Rayan-Radwan/smart-home-control-hub-pic16f877a/docs/Smart Home Block diagram.drawio.pdf

# Smart Home Block Diagram

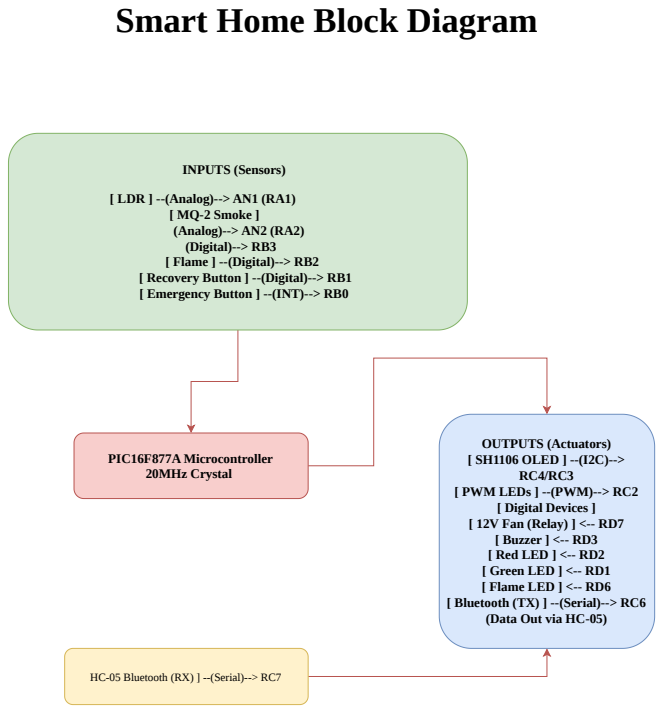
[picture p2: page 1]
INPUTS (Sensors); [ LDR ] --(Analog)--> AN1 (RA1); OUTPUTS (Actuators) [ SH1106 OLED ] --(I2C)--> RC4/RC3; PIC16F877A Microcontroller 20MHz Crystal

[ MQ-2 Smoke ]
(Analog)--> AN2 (RA2)
(Digital)--> RB3
[ Flame ] --(Digital)--> RB2
[ Recovery Button ] --(Digital)--> RB1
[ Emergency Button ] --(INT)--> RB0

[ PWM LEDs ] --(PWM)--> RC2
[ Digital Devices ]
[ 12V Fan (Relay) ] <-- RD7
[ Buzzer ] <-- RD3
[ Red LED ] <-- RD2
[ Green LED ] <-- RD1
[ Flame LED ] <-- RD6
[ Bluetooth (TX) ] --(Serial)--> RC6
(Data Out via HC-05)

HC-05 Bluetooth (RX) ] --(Serial)--> RC7
