Rayan-Radwan/smart-home-control-hub-pic16f877a/docs/Smart home Flowchart.drawio.pdf

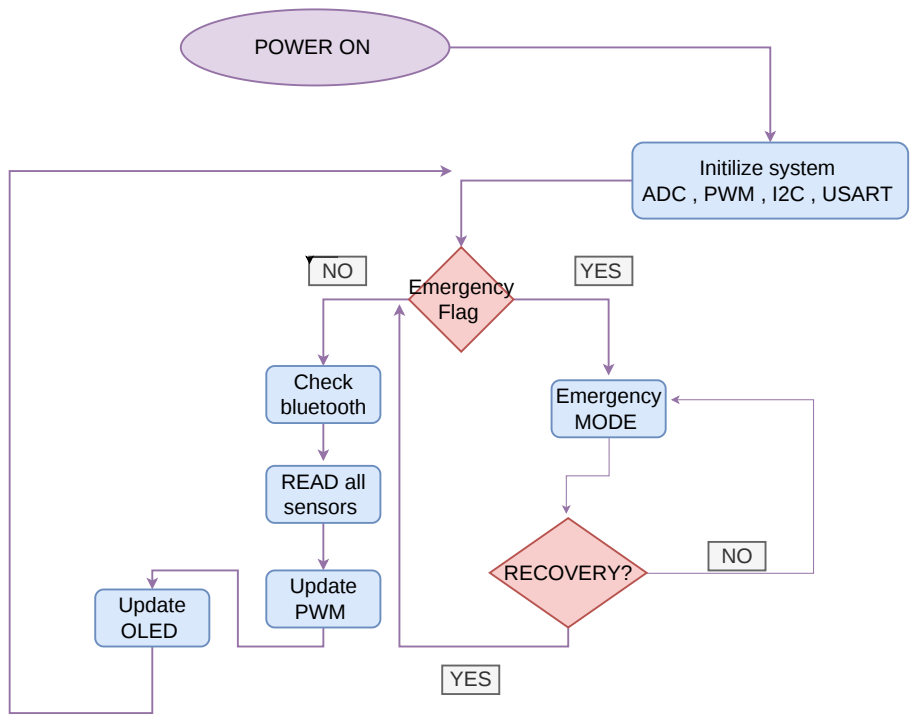
[picture p3: page 1]
POWER ON; Emergency Flag; Emergency MODE; Check bluetooth; READ all sensors; Update; PWM; OLED; RECOVERY?; YES

Initilize system
ADC , PWM , I2C , USART
