Rayan-Radwan/smart-home-control-hub-pic16f877a/(list of files, drawings)

Other design files:
proteus/Project.pdsprj
